firstyearstudent/Power_Bank_Rev/Giai_phap_do_nuoc.docx

TÀI LIỆU KỸ THUẬT: GIẢI PHÁP PHÁT HIỆN NƯỚC & ĐIỀU KHIỂN SẠC DOCK 12V

Thiết kế phần cứng hoàn thiện theo sơ đồ nguyên lý: Power_Bank_Rev1.kicad_sch

1. Tổng quan & 5 Mục tiêu kỹ thuật cốt lõi

Mạch điều khiển dò nước và sạc dock 12V trên bo mạch thử nghiệm Power_Bank_Rev1 được thiết kế với kiến trúc tối ưu (giảm 5 linh kiện so với bản cũ), kết hợp cảm biến từ trường Hall Active-HIGH TMAG5231A2 (U1) và công tắc Analog Switch SPST Active-HIGH TS5A3166 (U6), nhằm đáp ứng trọn vẹn 5 mục tiêu kỹ thuật an toàn cao cấp:

- 1. Chống ăn mòn điện hóa tiếp điểm Pogo Pin (Electrolytic Corrosion Prevention): Khi thiết bị ở ngoài môi trường (chưa cắm dock sạc), các chân kim Pogo Pin J6 (dò nước) và J5 (nguồn 12V) phải được giữ ở mức 0.0V tuyệt đối. Không cấp điện áp mồi thường trực ra chân Pogo để triệt tiêu hoàn toàn dòng điện phân khi tiếp xúc với mồ hôi tay hoặc nước mưa, bảo vệ vĩnh viễn lớp mạ vàng của chân kim.
- 2. Nhận diện trạng thái cắm Dock bằng cảm biến Hall Active-HIGH (U1): Trên dock sạc có bố trí một viên nam châm vĩnh cửu. Chỉ khi thiết bị được cắm khít vào dock sạc (từ trường B >= B_OP = 1.8mT), cảm biến Hall U1 (TMAG5231A2) mới kích hoạt ngõ ra lên mức 3.3V (HIGH), bơm điện áp mồi qua điện trở R9 (150kΩ) ra chân J6 sẵn sàng cho chu trình dò nước.
- 3. Dò nước an toàn trước khi kích hoạt sạc công suất cao 12V: Nếu các chân tiếp xúc Pogo Pin đang bị đọng nước (điện trở rò nước R_water < 50kΩ - 100kΩ), giọt nước sẽ kéo tụt điện áp tại nút dò nước IN xuống dưới ngưỡng 0.8V. Công tắc U6 (TS5A3166) lập tức giữ HỞ MẠCH đường giao tiếp CC1 của IC xin áp U2 (CH221K). IC nguồn U5 (IP5356) không nhận diện được thiết bị Sink trên đường CC nên giữ áp VBUS ở mức 0.0V, loại trừ hoàn toàn nguy cơ phóng tia lửa điện, hồ quang và chập cháy nguồn 12V qua giọt nước.
- 4. Điều kiện kép bật sạc 12V (Logic AND): Nguồn sạc 12V tại Pogo Pin J5 chỉ được kích hoạt khi hội tụ đồng thời cả 2 điều kiện an toàn: ĐÃ CẮM DOCK (Hall U1 phát hiện nam châm xuất 3.3V) VÀ TIẾP ĐIỂM HOÀN TOÀN KHÔ RÁO (R_water = vô cùng).
- 5. Dập hồ quang và ngắt sạc khẩn cấp trong nanogiây: Nếu đang trong quá trình sạc 12V mà có nước tràn vào tiếp điểm dock sạc, giọt nước kéo sụt áp nút IN xuống < 0.8V. Công tắc U6 ngắt tiếp điểm CC1 trong thời gian siêu nhanh t_OFF <= 10ns. IC nguồn IP5356 nhận diện mất Sink liền ngắt ngay VBUS về 0.0V, dập tắt hồ quang tức thì để bảo vệ bo mạch.

2. Kiến trúc hệ thống & Sơ đồ khối nguyên lý

Toàn bộ khối dò nước và kích hoạt sạc 12V trên bo mạch Power_Bank_Rev1 được liên kết theo chuỗi điều khiển khép kín từ cảm biến từ trường đến IC nguồn sạc:

+--------------------------+
| Dock sạc (Nam châm) |
+------------+-------------+
| (Từ trường B >= 1.8mT)
v
+--------------------------+ (R9 = 150kΩ)
| U1: TMAG5231A2 (Hall) |----+---/\/\/\---+ (Nút IN)
| Active-HIGH (Push-Pull) | | |
+--------------------------+ | +-----------------------+
| | |
| [ D1 ] BAV99/BAT54S v (Chân 4: IN)
| (Kẹp 0V - 3.3V) +-------------------+
| | | U6: TS5A3166DBVR |
| (R10 = 22kΩ) | (Analog Switch NO)|
| R_prot | Active-HIGH |
+--------------------------+ +---/\/\/\---+ (WATER_DETECT) +----+---------+----+
| Pogo Pin J6 (Dò nước) |-----------------+ | COM | NO
+--------------------------+ | |
| (CC1) | (Net-U2-CC1)
+--------------------------+ v v
| U5: IP5356 Power Bank |<=======================================+ +-------------+
| (DRP Source PD/QC 12V) | Đường đàm phán USB PD CC1 | U2: CH221K |
+------------+-------------+ | (PD Sink) |
| VBUS 12V | (CFG = 47k) |
v +------+------+
+--------------------------+ |
| Pogo Pin J5 (Cấp 12.0V) | LED5 (Power Good)
+--------------------------+

3. Bảng thông số kỹ thuật chi tiết các linh kiện (BOM & References)

Dưới đây là bảng tổng hợp các linh kiện thuộc khối điều khiển dò nước, đàm phán nguồn và cấp sạc 12V trên sơ đồ nguyên lý Power_Bank_Rev1:

Ký hiệu | Mã MPN | Package | Thông số / Trị số | Nguồn cấp / Dòng | Vai trò & Chức năng kỹ thuật chi tiết
U1 | TMAG5231A2DQDBZR | SOT-23-3 (DBZ) | B_OP = 1.8mT B_RP = 1.2mT | VCC (3.3V) I_q ≈ 2.0µA | Cảm biến từ trường Hall số (Digital Switch), Omnipolar, Push-Pull Active-HIGH. Xuất 3.3V khi cắm dock và 0.0V khi ngoài dock. (LCSC: C17378950).
U6 | TS5A3166DBVR | SOT-23-5 (DBV) | R_ON ≈ 0.9Ω BW = 200MHz | VCC (3.3V) I_q ≈ 0.1µA | Công tắc Analog Switch SPST, Normally-Open (NO), Active-HIGH (IN >= 2.0V đóng; IN <= 0.8V ngắt). Dùng để đóng/cắt đường CC1 giữa IP5356 và CH221K.
U2 | CH221K | SOT-23-6 | PD3.0/2.0 Sink CFG = 47kΩ (12V) | VDD (VBUS) I_op ≈ 1.5mA | IC đàm phán nguồn USB PD Sink. Khi được cấp nguồn và đóng đường CC1, CH221K gửi gói tin Request xin áp 12V từ IP5356. Chân ~PG kéo mức LOW bật LED5 khi 12V sẵn sàng.
U5 | IP5356 | VQFN-40 (6x6mm) | SOC Sạc dự phòng Công suất 22.5W | Pin Li-ion 1S (3.0V - 4.2V) | IC quản lý nguồn tích hợp sạc Buck 18W và Boost 22.5W ra 12V. Hỗ trợ DRP Type-C, tự động điều chỉnh điện áp VBUS theo đàm phán PD từ CH221K.
D1 | BAT54S / BAV99 | SOT-23-3 | V_R = 70V I_F = 200mA | - | Diode đôi kẹp bảo vệ quá áp/âm áp tại nút IN. Kẹp điện áp nút IN không vượt quá VCC + 0.35V và không âm dưới -0.35V. Khuyến nghị dùng BAV99 (dòng rò < 5nA).
R9 | Resistor 150kΩ | 0603 | 150kΩ ±1% | - | Điện trở cấp áp mồi (Pull-up) từ chân OUT của U1 đến nút IN. Trị số 150kΩ được tối ưu để phân áp với nước sinh hoạt (10k-50kΩ) kéo tụt áp IN < 0.8V khi bị ướt.
R10 | Resistor 22kΩ (R_prot) | 0603 | 22kΩ ±1% | - | Điện trở hạn dòng bảo vệ hệ thống. Mắc nối tiếp giữa chân Pogo J6 và nút IN. Khi vô tình chập 12V từ J5 sang J6, R10 hạn dòng xả qua D1 về VCC ở mức 0.38mA, chống nổ nguồn 3.3V.
R12 | Resistor 1.0kΩ (R_VDD) | 0603 | 1.0kΩ ±1% | - | Điện trở cấp nguồn Shunt cho CH221K từ đường VBUS. Trị số 1.0kΩ cấp đủ 1.7mA ở áp mồi 5V ban đầu, đảm bảo VDD không bị sụt dưới ngưỡng Reset 2.4V.
R13 | Resistor 47kΩ (R_CFG) | 0603 | 47kΩ ±1% | - | Điện trở cấu hình mức điện áp xin cấp của CH221K. Nối giữa CFG (chân 6) và VDD (chân 1) để chọn cấu hình xin điện áp 12.0V.
R11 | Resistor 5.1kΩ (DNI) | 0603 | 5.1kΩ ±1% (DNP) | - | Điện trở kéo chân CC2 của CH221K xuống GND. Cài đặt DNI để làm điểm thử nghiệm, đồng thời loại bỏ cảnh báo hở chân trong báo cáo KiCad ERC.
R14 | Resistor 1.0kΩ (R_PG) | 0603 | 1.0kΩ ±1% | - | Điện trở kéo lên (Pull-up) từ đường VCC (3.3V) đến chân Open-Drain ~PG của CH221K, đồng thời hạn dòng nuôi đèn LED5.
LED5 | LED_0805_Red | 0805 | V_F ≈ 1.9V I_F ≈ 1.4mA | - | Đèn LED hiển thị trạng thái 12V Power Good. Tự động sáng khi CH221K đàm phán thành công mức áp 12V.
J5 | Pogo Pin | MILL-MAX 0906-1 | Chịu dòng 5A-8A | - | Chân tiếp xúc Pogo Pin cấp nguồn sạc 12.0V ra thiết bị ngoài (nối vào đường VBUS / VDD).
J6 | Pogo Pin | MILL-MAX 0906-1 | Chân kim mạ vàng | - | Chân tiếp xúc Pogo Pin dò nước (nối vào đường WATER_DETECT trước trở R10).
J7 | Pogo Pin | MILL-MAX 0906-1 | Chân kim mạ vàng | - | Chân tiếp xúc Pogo Pin nối mass hệ thống (GND).
J3, J4 | Solder Pad 6.5mm (Conn_01x01) | Pad tròn 6.5mm | Chịu dòng cao | - | Điểm hàn dây cực dương (J3: BAT+) và cực âm (J4: BAT-/GND) của Cell pin 1S Li-ion/Lipo.

4. Tính toán điện học & Ngưỡng dò nước an toàn

Nút điều khiển IN nối vào chân 4 của công tắc TS5A3166 (U6). Khi U6 được nuôi bằng nguồn VCC = 3.3V, ngưỡng chuyển mạch chuẩn CMOS gồm:

• Điện áp nhận diện mức HIGH (Đóng công tắc U6): V_IN >= V_IH(min) = 2.0 V
• Điện áp nhận diện mức LOW (Hở công tắc U6): V_IN <= V_IL(max) = 0.8 V
• Vùng bất định (Cần tránh rơi vào): 0.8 V < V_IN < 2.0 V

4.1. Công thức phân áp khi cắm vào Dock sạc

Khi thiết bị cắm khít vào dock sạc có nam châm, cảm biến Hall U1 kích hoạt ngõ ra lên V_OUT = 3.3V. Mạch tạo thành cầu phân áp giữa điện trở R9 (150kΩ) kéo lên 3.3V và nhánh dưới gồm điện trở bảo vệ R10 (22kΩ) mắc nối tiếp với điện trở rò của giọt nước R_water xuống mass (J7):

R10 + R_water 22kΩ + R_water
V_IN = ----------------------- x 3.3V = ---------------------- x 3.3V
R9 + R10 + R_water 172kΩ + R_water

Trạng thái tiếp điểm Dock | Điện trở rò nước (R_water) | Điện trở nhánh dưới (R10 + R_water) | Điện áp nút IN (V_IN) | Trạng thái công tắc U6 & Nguồn 12V
Đọng nước muối / Nước dơ cao | 5 kΩ | 27 kΩ | 0.45 V (<= 0.8V) | U6 NGẮT (OFF) -> Khóa 12V (VBUS = 0V)
Đọng nước máy sinh hoạt | 15 kΩ | 37 kΩ | 0.59 V (<= 0.8V) | U6 NGẮT (OFF) -> Khóa 12V (VBUS = 0V)
Đọng nước mưa / Nước tinh khiết | 30 kΩ | 52 kΩ | 0.77 V (<= 0.8V) | U6 NGẮT (OFF) -> Khóa 12V (VBUS = 0V)
Màng ẩm mỏng sắp bay hơi | 50 kΩ | 72 kΩ | 0.98 V (Vùng chuyển tiếp) | U6 giữ trạng thái ngắt an toàn
Mồ hôi tay khô / Không khí ẩm | 150 kΩ | 172 kΩ | 1.65 V | Không đóng mạch sạc (chưa đủ 2.0V)
HOÀN TOÀN KHÔ RÁO (Chuẩn) | Vô cùng (Hở mạch) | Vô cùng | 3.30 V (>= 2.0V) | U6 ĐÓNG (ON) -> BẬT SẠC 12.0V

4.2. Cơ chế bảo vệ quá áp khi chập chân 12V (J5) sang chân dò nước (J6)

Chân kim Pogo J5 (12V) và J6 (dò nước) nằm ngay cạnh nhau với khoảng cách chỉ vài milimét. Nếu người dùng vô tình làm rơi chìa khóa, đồng xu hoặc giọt nước muối nối tắt chân J5 sang J6:
• Không có R10: Nguồn 12V sẽ xông thẳng qua Diode D1 vào đường 3.3V (VCC). Do chân 20 của IP5356 chịu tối đa 3.6V, toàn bộ IC trên đường 3.3V sẽ nổ ngay lập tức.
• Khi có R10 = 22kΩ: Diode D1 dẫn kẹp điện áp nút IN ở mức V_clamp = VCC + V_F ≈ 3.3V + 0.35V = 3.65V. Dòng sự cố xả qua D1 được giới hạn an toàn ở mức:

V_J5 - V_clamp 12.0V - 3.65V
I_clamp = ---------------- = ----------------- = 0.38 mA
R10 22kΩ

Dòng điện 0.38mA là cực nhỏ, được đường nguồn 3.3V và các tụ bypass hấp thụ dễ dàng mà không làm dâng điện áp nguồn VCC, bảo vệ an toàn 100% cho bo mạch.

5. Bảng chân lý hoạt động của từng linh kiện thành phần

5.1. Cảm biến Hall U1 (TMAG5231A2 - Push-Pull, Active-HIGH)

Từ trường (B) | Trạng thái tiếp xúc Dock | Điện áp chân 2 (OUT) | Mức logic | Hành vi đối với điện trở R9
B < B_RP (Không có nam châm) | Chưa cắm dock (Ở ngoài môi trường) | 0.0 V | LOW | R9 kéo nút IN và chân J6 về 0.0V (chống ăn mòn mạ vàng).
B >= B_OP (Có nam châm dock) | Đã cắm khít vào dock sạc | 3.3 V | HIGH | R9 kéo lên 3.3V, cấp điện áp mồi sẵn sàng cho chu trình dò nước.

5.2. Công tắc Analog Switch U6 (TS5A3166 - Active-HIGH)

Điện áp chân 4 (IN) | Mức logic điều khiển | Tiếp điểm Pin 1 - Pin 2 | Giao tiếp CC1 với CH221K | Điện áp cấp ra Pogo J5
V_IN <= 0.8 V (Ướt / Ngoài dock) | LOW | HỞ MẠCH (OFF / Cách ly) | Ngắt hoàn toàn đường CC1. IP5356 không nhận diện tải Sink. | KHÓA NGUỒN (0.0 V)
V_IN >= 2.0 V (Khô ráo trong dock) | HIGH | ĐÓNG MẠCH (ON / Dẫn) | Nối thông CC1 sang CH221K. CH221K đàm phán USB PD 12V. | BẬT SẠC 12.0 V

6. BẢNG CHÂN LÝ HOẠT ĐỘNG TOÀN MẠCH (FULL SYSTEM TRUTH TABLE)

Bảng chân lý tổng hợp toàn diện cả 5 kịch bản vận hành thực tế của bo mạch Power_Bank_Rev1:

STT | Kịch bản hoạt động thực tế | Điện trở rò nước (R_water) | Chân 2 U1 (Hall) | Chân kim J6 & Nút IN | Công tắc U6 (TS5A3166) | Điện áp Pogo J5 | Hiện tượng & Cơ chế an toàn hệ thống
1 | Chế độ chờ ngoài dock (Khô ráo) | Vô cùng (Hở) | 0.0 V (LOW) | 0.0 V | OFF (Hở) | 0.0 V (Khóa) | Pogo J6 ở mức 0.0V tuyệt đối, không bị ngâm điện áp mồi, triệt tiêu hoàn toàn hiện tượng ăn mòn điện hóa tiếp điểm mạ vàng.
2 | Chế độ chờ ngoài dock (Dính mưa / Mồ hôi) | < 50 kΩ (Ướt) | 0.0 V (LOW) | 0.0 V | OFF (Hở) | 0.0 V (Khóa) | Do U1 xuất 0V nên không có dòng điện phân chạy qua giọt nước/mồ hôi, tiếp điểm kim hoàn toàn an toàn.
3 | Cắm dock BỊ ĐỌNG NƯỚC (Nguy cơ chập cháy) | 10kΩ - 50kΩ (Ướt) | 3.3 V (HIGH) | 0.45V - 0.77V (<= 0.8V) | OFF (Hở chặt) | 0.0 V (Khóa chặt) | KHÓA 12V KHẨN CẤP: Giọt nước kéo tụt áp mồi, U6 giữ hở mạch CC1. CH221K không thể gửi yêu cầu đàm phán -> J5 giữ 0.0V, dập tắt nguy cơ phóng hồ quang và đoản mạch.
4 | Cắm dock HOÀN TOÀN KHÔ (Đủ điều kiện an toàn) | Vô cùng (Khô) | 3.3 V (HIGH) | 3.3 V (>= 2.0V) | ON (Đóng thông) | 12.0 V (BẬT SẠC) | HỘI TỤ ĐỦ 2 ĐIỀU KIỆN AN TOÀN: Đã cắm dock + Khô ráo. U6 đóng thông đường CC1, CH221K đàm phán PD kéo VBUS lên 12.0V cấp ra J5, đèn LED5 sáng báo Power Good.
5 | Đang sạc 12V bị nước tràn (Sự cố đột xuất khi sạc) | Vô cùng -> <50kΩ (Bị ướt) | 3.3 V (HIGH) | 3.3V tụt xuống <= 0.77V | NGẮT NGAY LẬP TỨC | 12V dập về 0.0 V | DẬP HỒ QUANG TỨC THÌ: Khi nước chạm J6, U6 ngắt CC1 trong thời gian < 10ns. IP5356 phát hiện mất tải Sink liền hạ VBUS về 0V ngay lập tức, triệt tiêu dòng chập.

7. Các lưu ý phần cứng hoàn thiện trên Schematic Power_Bank_Rev1

• Cấu hình DNI cho các cổng phụ để kích hoạt chế độ Sạc nhanh đơn cổng (Single-Port Fast Charge): IC nguồn IP5356 có cơ chế an toàn đa cổng: nếu phát hiện nhiều hơn 1 cổng có tải hoặc có tụ lọc lớn nối song song, nó sẽ tự động ép điện áp ra về 5V tiêu chuẩn và khóa chức năng nâng áp 12V. Trên schematic Power_Bank_Rev1, các cổng phụ gồm Micro-B (P3, C1), USB-A 1 (P1, C3, C6), và Header 4 chân (J2, C4, C7) đều đã được gán thuộc tính 'dnp = yes' (DNI). Nhờ đó, IP5356 nhận diện mạch chỉ có duy nhất 1 cổng VBUS hoạt động, mở khóa toàn bộ công suất đàm phán 12V tối đa.

• Cơ chế sạc lại Pin qua cổng Type-C J1 khi ở ngoài Dock: Khi thiết bị ở ngoài dock, cảm biến Hall U1 xuất 0V khiến công tắc U6 hở mạch (cách ly hoàn toàn CH221K khỏi đường CC1). Khi người dùng cắm củ sạc ngoài vào cổng Type-C J1, đường CC1 và CC2 của củ sạc kết nối trực tiếp với IP5356 mà không bị CH221K can thiệp hay xung đột. IP5356 tự động nhận diện nguồn sạc ngoài và tiến hành sạc pin Li-ion qua cuộn cảm L1 hoàn toàn bình thường.

• Cặp chân dữ liệu D+ và D- của cổng Type-C J1: Đã đấu nối chuẩn xác: Chân A6/B6 (D+) nối vào net /DPC (chân 25 của IP5356) và chân A7/B7 (D-) nối vào net /DMC (chân 26 của IP5356). Đảm bảo các giao thức sạc nhanh QC 2.0/3.0, FCP, AFC, BC1.2 hoạt động chính xác.

• Cặp Pad hàn Pin 1S chịu dòng cao (J3: BAT+ và J4: BAT-/GND): Được bố trí bằng Footprint Solder Pad tròn 6.5mm lớn, đảm bảo đủ tiết diện hàn dây pin Li-ion chịu dòng sạc/xả đỉnh 5A - 8A của cuộn cảm L1 (2.2µH).

• Điện trở cấu hình dung lượng Pin R6 (22kΩ) và NTC R8 (10kΩ): Chân 10 (LED5) của IP5356 gắn điện trở R6 = 22kΩ nối mass để cài đặt dung lượng pin chuẩn là 10,000 mAh cho bộ đếm Coulombmeter. Chân 22 (NTC) gắn điện trở R8 = 10kΩ xuống mass mô phỏng cảm biến nhiệt độ ở mức 25°C, giúp mạch khởi động sạc/xả bình thường khi chưa hàn cảm biến NTC ngoài.
