firstyearstudent/Power_Bank_Rev/Giai_phap_do_nuoc_goc.docx

1. Bảng thông số

KH | MPN | Package | Nguồn nuôi | Dòng tĩnh | Đặc điểm
U3 | DRV5032DUDBZR | SOT-23-3 | 1.65V-5.5V | 0.69 μA | • Ngõ ra: Push-Pull, Active-HIGH • Ngưỡng bật: B_(OP) =3.3mT • Ngưỡng nhả: B_(RP) =1.5mT-3mT • Nhạy cực Nam (Unipolar South)
D1 | BAT54S | SOT-23-3 | V_R =30V | I_R ≤2μA | • 2 Diode Schottky mắc nối tiếp • Sụt áp thuận: V_F ≈0.35V • Dòng thuận cực đại: 200mA
U1 | TLV3691IDCK | SOT-353 (SC-70-5) | 0.9V-6.5V | 75nA | • Ngõ ra: Push-Pull • Dòng rò ngõ vào: I_(bias) ≈1pA • Trễ truyền: 32 μs
U4 | TS5A3167DBVR | SOT-23-5 | 1.65V-5.5V | 0.1 μA | • Công tắc SPST 1 kênh, Active-LOW

2. Bảng chân lý
- Cảm biến từ trường Hall DRV5032DUDBZR (U3):

Cường độ từ trường cực(B) | Trạng thái tiếp xúc với Dock | Điện áp Chân 2 (OUT2) | Mức Logic ngõ ra | Vai trò của R9
B<B_(RP) | Chưa cắm dock | 0V | LOW | R9 trở thành trở Pull-down, kéo chân Pogo J6 và IN- về 0V.
B≥B_(OP) | Đã cắm dock | 3.3V | HIGH | R9 trở thành trở Pull-up, cấp áp mồi 3.3V ra chân Pogo J6 để dò nước.

- Diode đôi kẹp áp bảo vệ BAT54S (D1);

Điện áp tại chân Pogo J6 | Trạng thái Diode dưới (Pin 1 → Pin 3) | Trạng thái Diode trên (Pin 3 → Pin 2) | Điện áp kẹp tại Chân 3 (IN- của U1) | Tác dụng bảo vệ
V_(J6) <-0.35V | Dẫn thuận (ON) | Phân cực ngược (OFF) | ≈-0.35V | Xả xung âm từ GND, chống đánh thủng cổng CMOS của U1.
0V<V_(J6) ≤3.3V | Phân cực ngược (OFF) | Phân cực ngược (OFF) | Bằng V_(J6) | Cách ly hoàn toàn, không làm sai lệch áp dò nước.
V_(J6) >3.65V | Phân cực ngược (OFF) | Dẫn thuận (ON) | ≈3.65V | Xả dòng quá áp lên đường nguồn VCC.

- Bộ so sánh điện áp TLV3691IDCK (U1):

Kịch bản tại chân Pogo J6 | Điện áp Chân 3 | Điện áp Chân 1 | Phép so sánh | Ngõ ra Chân 4 | Mức Logic
Chưa cắm dock | 00V | 1.65V | IN- < IN+ | 3.3V | HIGH
Cắm dock bị ƯỚT | ≈0.03V-0.15V | 1.65V | IN- < IN+ | 3.3V | HIGH
Cắm dock KHÔ RÁO | 3.3V | 1.65V | IN- > IN+ | 0V | LOW

- Công tắc Analog Switch TS5A3167DBVR (U4):

Điện áp Chân 4 (IN) | Mức Logic điều khiển | Trạng thái tiếp điểm (Pin 1 – Pin 2) | Trạng thái IC xin áp CH221K (U2) | Điện áp sạc
3.3V | HIGH | HỞ MẠCH (OFF) | Bị ngắt đường CC1, không thể đàm phán | KHÓA 12V
0V | LOW | ĐÓNG MẠCH (ON) | Kết nối CC1 với IP5356, xin áp 12V | BẬT SẠC 12V

- Bảng chân lý của toán khối:

Kịch bản | Trở kháng nước | Chân 2 U3 | Chân Pogo J6 | Chân 3 U1 (IN-) | So sánh với IN+ | Chân 4 U1 (OUT) | Công tắc U4 | Trạng thái sạc tại Pogo J5 | Hiện tượng
Chế độ chờ (Khô ráo) | ∞ | 0 | 0 | 0 | 0V<1.65V | 3.3V | OFF | KHÓA (0V) | Chân Pogo J6 ở mức 0V, không ngâm điện.
Chế độ chờ (Dính mưa / Mồ hôi) | <100kΩ | 0 | 0 | 0 | 0V<1.65V | 3.3V | OFF | KHÓA (0V) | Không có áp mồi → không ăn mòn lớp mạ vàng Pogo pin.
Cắm dock BỊ ĐỌNG NƯỚC (Nguy hiểm) | 20k Ω -100k Ω | 3.3V | ≈0.03V-0.15V | ≈0.03V-0.15V | 0.15V<1.65V | 3.3V | OFF | KHÓA CHẶT 12V | Cô lập CH221K, ngăn 12V phóng hồ quang qua giọt nước.
Cắm dock HOÀN TOÀN KHÔ | ∞ | 3.3V | 3.3V | 3.3V | 3.3V>1.65V | 0V | ON | BẬT SẠC 12V | Hội tụ đủ 2 điều kiện: cắm dock + Khô ráo.
Đang sạc 12V bị nước tràn vào | ∞ về <100k Ω | 3.3V | 0.15V | 0.15V | <1.65V | 3.3V | OFF | NGẮT 12V KHẨN CẤP | Ngắt ngay đường CC1 khi nước chạm J6.
