firstyearstudent/Power_Bank_Rev/Power_Bank_Rev1.csv

Reference | Qty | Value | Footprint
C1,C2,C3,C4,C17 | 5 | 2.2uF_0603 | PCM_Capacitor_SMD_AKL:C_0603_1608Metric
C5,C6,C7,C15,C16,C18 | 6 | 100nF_0603 | PCM_Capacitor_SMD_AKL:C_0603_1608Metric
C8,C9,C10,C11,C12,C13,C14 | 7 | 22uF | PCM_SparkFun-Capacitor:C_0805_2012Metric
C19 | 1 | 0.1uF | PCM_SparkFun-Capacitor:C_0603_1608Metric
C20 | 1 | 1uF_0603 | PCM_Capacitor_SMD_AKL:C_0603_1608Metric
D1 | 1 | 1N5819 | PCM_Diode_THT_AKL:D_DO-41_SOD81_P7.62mm_Horizontal
DZ1 | 1 | MMSZ5V1 | PCM_Diode_SMD_AKL:D_SOD-123
J1 | 1 | USB_C_Receptacle | PCM_SparkFun-Connector:USB-C_16
L1 | 1 | 2.2uH | Components_Footprint:IND_F1F3-1004T-2R2M
LED1,LED2 | 2 | LED_0603_Red | PCM_LED_SMD_AKL:LED_0603_1608Metric
LED3 | 1 | 100% | PCM_LED_SMD_AKL:LED_0603_1608Metric
LED4 | 1 | 75% | PCM_LED_SMD_AKL:LED_0603_1608Metric
LED5 | 1 | 100% | PCM_LED_SMD_AKL:LED_0805_2012Metric
LED6 | 1 | 50% | PCM_LED_SMD_AKL:LED_0603_1608Metric
LED7 | 1 | 25% | PCM_LED_SMD_AKL:LED_0603_1608Metric
P1 | 1 | Conn_USB_A_Socket | PCM_fab:Conn_USB_A_Socket_AdamTech_USB-A-S-RA-TSMT
P2 | 1 | USB_C_Plug_USB2.0 | Connector_PinHeader_2.54mm:PinHeader_1x05_P2.54mm_Vertical
P3 | 1 | Conn_USB_microB_Socket | PCM_fab:Conn_USB_microB_Socket_WurthElektronik_629105136821
R1,R2,R4 | 3 | 100R_0603 | PCM_fab:R_0603
R3 | 1 | 10k_0603 | PCM_fab:R_0603
R5 | 1 | 20R_0603 | PCM_fab:R_0603
R6 | 1 | 22k_0603 | PCM_fab:R_0603
R8 | 1 | 10k | PCM_SparkFun-Resistor:R_0603_1608Metric
R13 | 1 | 47k | PCM_SparkFun-Resistor:R_0603_1608Metric
R14 | 1 | 1k | PCM_SparkFun-Resistor:R_0603_1608Metric
R15 | 1 | 3.3k | PCM_SparkFun-Resistor:R_0603_1608Metric
SW1 | 1 | Switch_Tactile_CnK | PCM_fab:Button_CnK_PTS636.0_6x3.5mm
U2 | 1 | CH221K | Components_Footprint:SOT95P280X120-6N
U3 | 1 | DRV5032FA | Package_TO_SOT_SMD:SOT-23
U4 | 1 | TS5A3167DBVR | Components_Footprint:SOT95P280X145-5N
U5 | 1 | IP5356 | EasyEDA:VQFN-40_L6.0-W6.0-P0.50-TL-EP4.2
