firstyearstudent/Power_Bank_Rev/Power_Bank_Rev1.pdf

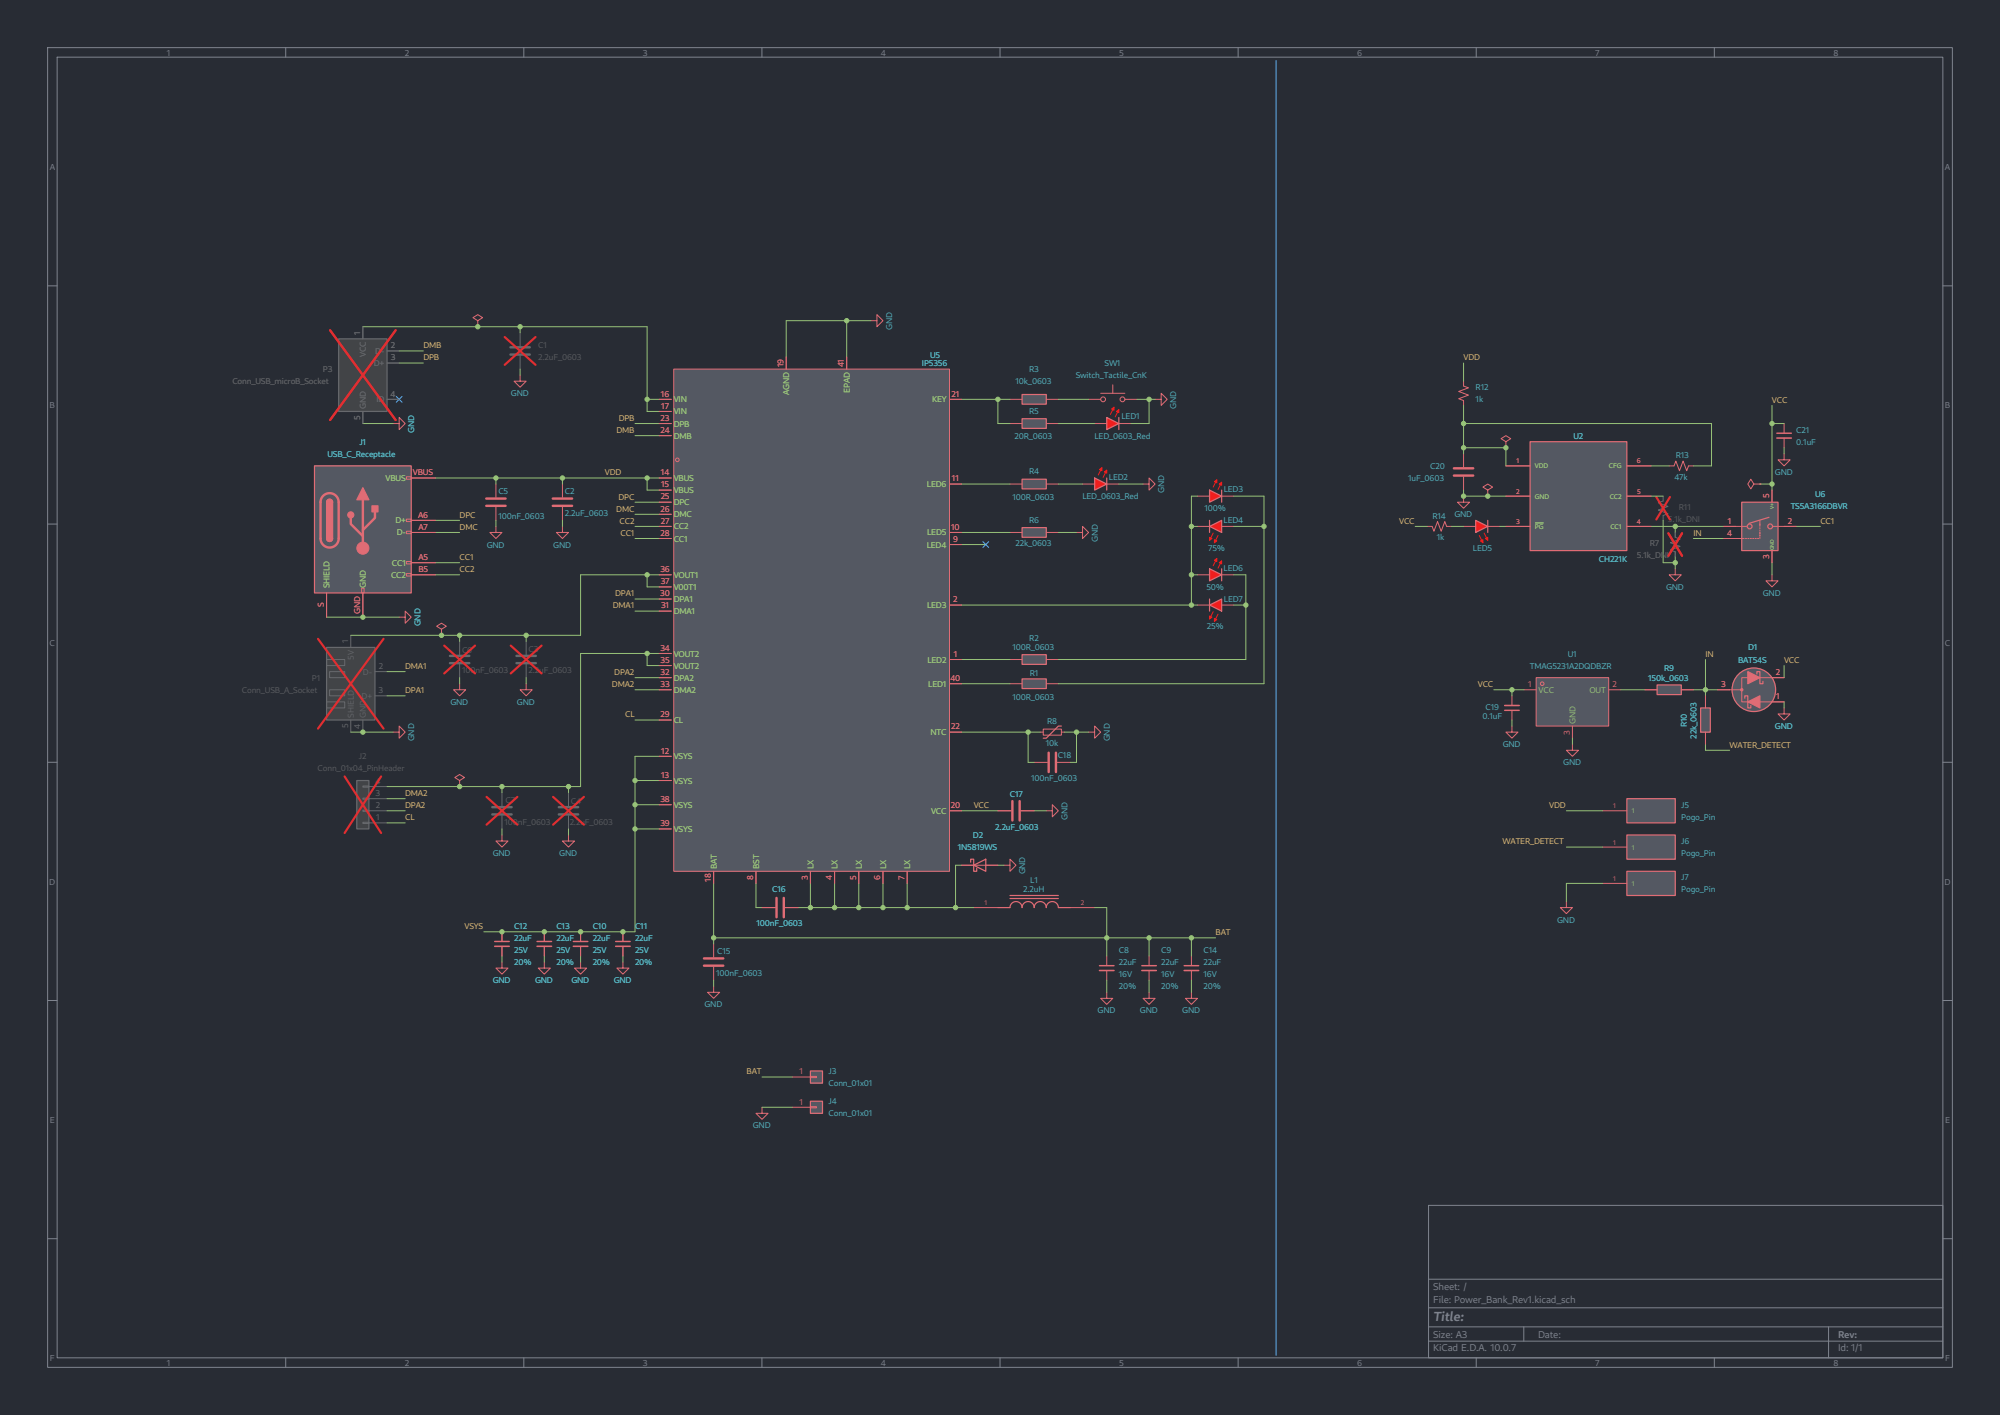
[picture p1: page 1]
