firstyearstudent/Power_Bank_Rev/Power_Bank_Rev1.kicad_pcb

## KiCad design Power_Bank_Rev1.kicad_pcb (2026-10-29)

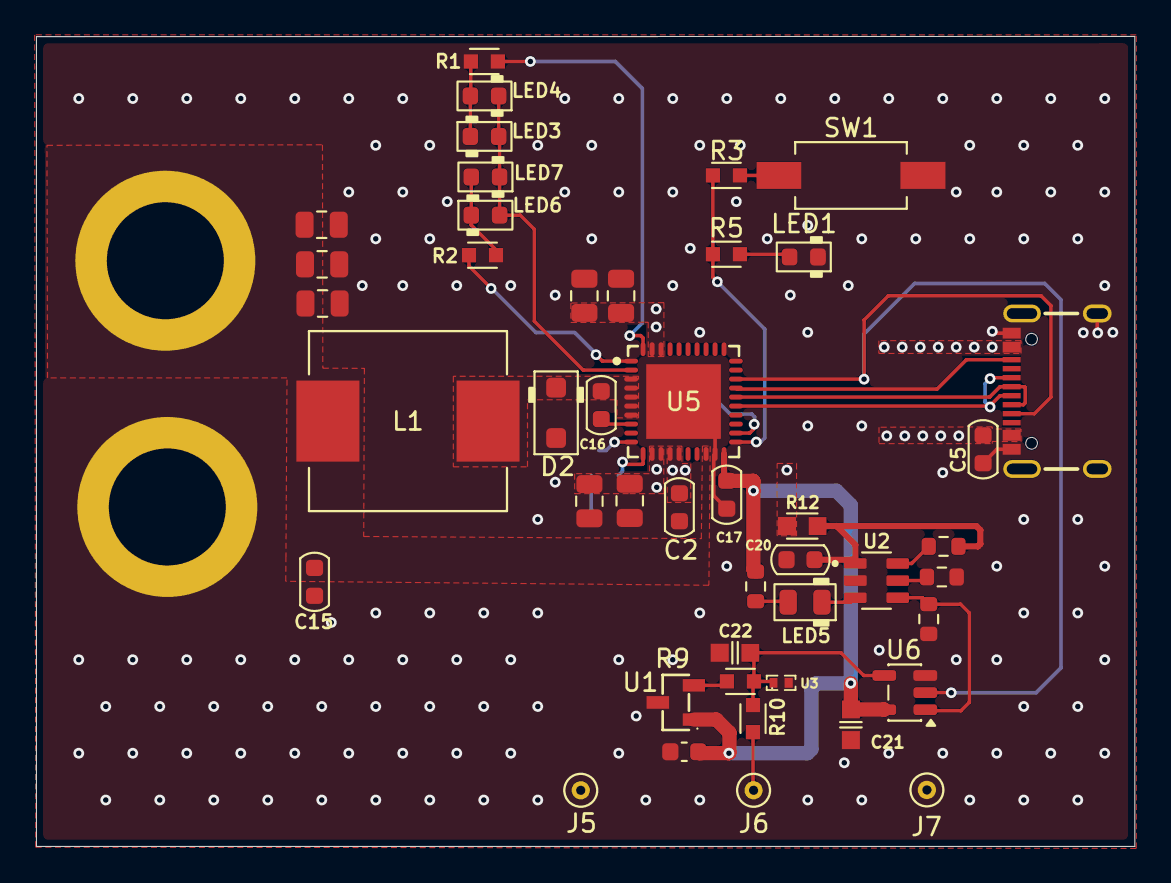
[picture p2: board Power_Bank_Rev1.kicad_pcb from above]

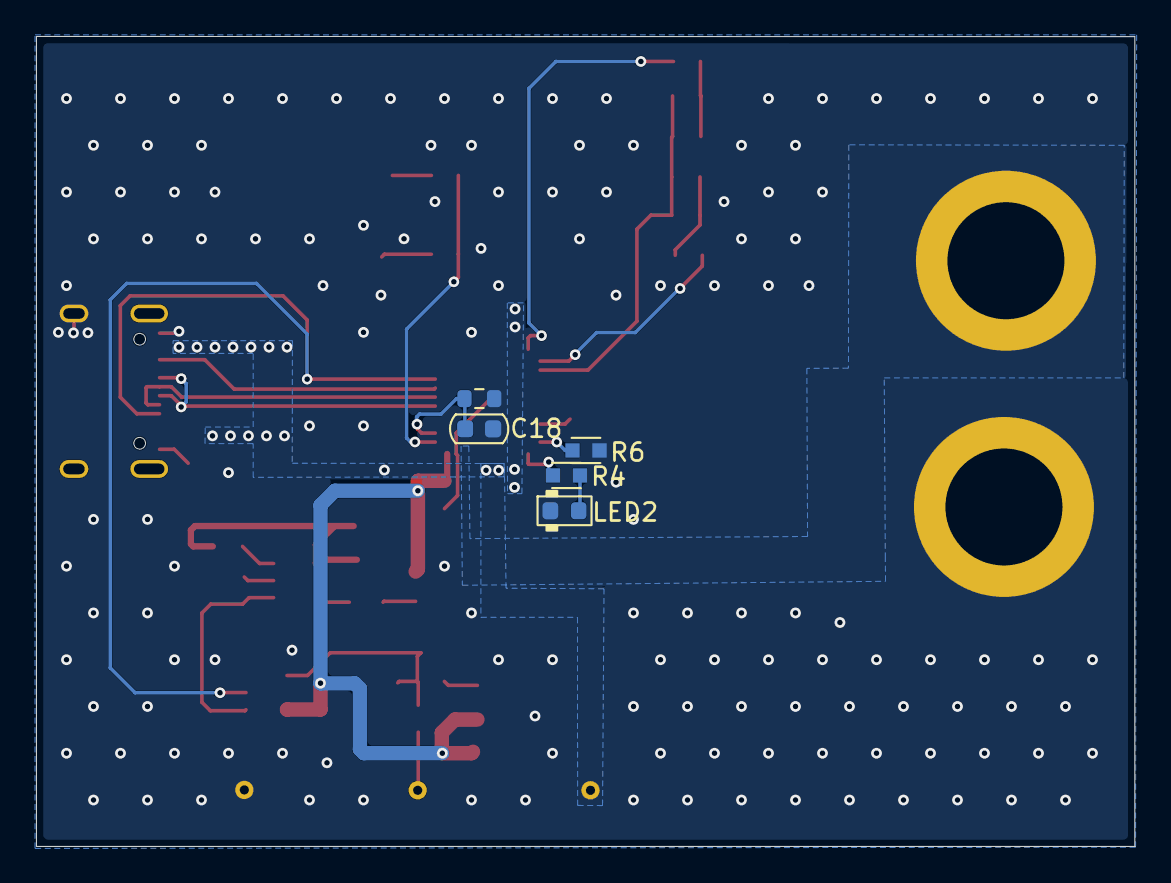
[picture p3: board Power_Bank_Rev1.kicad_pcb from below]

Board: 2 copper layers, 61.0 x 45.0 mm, 52 parts (5 on the bottom side), 32 nets.

Parts:
C2, C17: 2.2uF_0603; C_0603_1608Metric
C5, C15, C16, C18: 100nF_0603; C_0603_1608Metric
C8, C9, C10, C11, C12, C13, C14: 22uF; C_0805_2012Metric
C19: 0.1uF; C_0603_1608Metric
C20: 1uF_0603; C_0603_1608Metric
C21: 0.1uF_0603_16V; C_0603
C22: 10nF_0603_25V; C_0603
D2: PMEG4020ER; D_SOD-123F
J1: USB_C_Receptacle; USB-C_16
J3, J4: Conn_01x01; 1x01_6.5mm
J5, J6, J7: Pogo_Pin; MILL-MAX_0906-1-15-20-75-14-11-0
L1: 2.2uH; IND_F1F3-1004T-2R2M
LED1, LED2: LED_0603_Red; LED_0603_1608Metric
LED3: 100%; LED_0603_1608Metric
LED4: 75%; LED_0603_1608Metric
LED5: 100%; LED_0805_2012Metric
LED6: 50%; LED_0603_1608Metric
LED7: 25%; LED_0603_1608Metric
R1, R2, R4: 100R_0603; R_0603
R3: 10k_0603; R_0603
R5: 20R_0603; R_0603
R6, R10: 22k_0603; R_0603
R7, R11: 5.1k_DNI; R_0603_1608Metric
R8: 10k; R_0603_1608Metric
R9: 150k_0603; R_0603
R12: 1k_0603; R_0603
R13: 47k; R_0603_1608Metric
R14: 1k; R_0603_1608Metric
SW1: Switch_Tactile_CnK; Button_CnK_PTS636.0_6x3.5mm
U1: TMAG5231A2DQDBZR; SOT-23-3_L2.9-W1.3-P1.90-LS2.4-BL-1
U2: CH221K; SOT95P280X120-6N
U3: ESD5451N; DFN1006-2L-BI
U5: IP5356; VQFN-40_L6.0-W6.0-P0.50-TL-EP4.2
U6: TS5A3166DBVR; SOT-23-5

Connections:
/BAT: C8.1, C9.1, C14.1, C15.1, J3.1 (Pin_1_1), L1.2, U5.18 (BAT)
/CC1: J1.A5 (CC1), U5.28 (CC1), U6.2
/CC2: J1.B5 (CC2), U5.27 (CC2)
/DMC: J1.A7 (D-), J1.B7 (D-), U5.26 (DMC)
/DPC: J1.A6 (D+), J1.B6 (D+), U5.25 (DPC)
/IN: C22.1, R9.2, R10.2, U3.1, U6.4
/VCC: C17.1, C19.2, C21.1, R14.2, U1.1 (VCC), U5.20 (VCC), U6.5 (V+)
/VDD: C2.1, C5.1, J1.VBUS, J5.1 (1_1), R12.2, U5.14 (VBUS), U5.15 (VBUS)
/VSYS: C10.1, C11.1, C12.1, C13.1, U5.12 (VSYS), U5.13 (VSYS), U5.38 (VSYS), U5.39 (VSYS)
/WATER_DETECT: J6.1 (1_1), R10.1
GND: C2.2, C5.2, C8.2, C9.2, C10.2, C11.2, C12.2, C13.2, C14.2, C15.2, C17.2, C18.2, C19.1, C20.2, C21.2, C22.2, D2.2 (A), J1.GND, J1.S (SHIELD), J4.1 (Pin_1_1), J7.1 (1_1), LED1.1 (K), LED2.1 (K), R6.2, R7.1, R8.2, R11.1, SW1.2, U1.3 (GND), U2.2 (GND), U3.2, U5.19 (AGND), U5.41 (EPAD), U6.3 (GND)
unnamed: C16.2, D2.1 (K), L1.1, U5.3 (LX), U5.4 (LX), U5.5 (LX), U5.6 (LX), U5.7 (LX)
unnamed: LED1.2 (A), R5.1
unnamed: LED2.2 (A), R4.2
unnamed: LED3.2 (A), LED4.1 (K), LED6.2 (A), LED7.1 (K), U5.2 (LED3)
unnamed: LED3.1 (K), LED4.2 (A), R1.2
unnamed: LED5.2 (A), R14.1
unnamed: LED5.1 (K), U2.3 (~PG)
unnamed: LED6.1 (K), LED7.2 (A), R2.2
unnamed: R3.2, SW1.1
unnamed: R9.1, U1.2 (OUT)
unnamed: R7.2, U2.4 (CC1), U6.1
unnamed: R11.2, U2.5 (CC2)
unnamed: R13.1, U2.6 (CFG)
unnamed: C20.1, R12.1, R13.2, U2.1 (VDD)
unnamed: C16.1, U5.8 (BST)
unnamed: R3.1, R5.2, U5.21 (KEY)
unnamed: R1.1, U5.40 (LED1)
unnamed: R2.1, U5.1 (LED2)
unnamed: R6.1, U5.10 (LED5)
unnamed: R4.1, U5.11 (LED6)
unnamed: C18.1, R8.1, U5.22 (NTC)
